jcorbin/pchepa/run_log.md

2024-10-14 08:27 - showing fully charged, unplugged running at full
2024-10-14 10:38 - still going
2024-10-14 13:00 - dead

2024-10-14 13:00 - plugged in, turned knob off
2024-10-14 15:20 - still charging
2024-10-14 17:35 - fully charged
