jcorbin/pchepa/(list of files, cad)

Other CAD files:
duo/wall_noft_2.stl
parts/pwm_knob.stl
pchepa_duo-v1.3.0.3mf
test/power_module.stl
duo/grill_box_b.stl
parts/base_bank_channel_plug.stl
pchepa_tests-v1.3.0.3mf
test/label_plate_a.stl
duo/base_batt_a.stl
parts/wall_bender.stl
test/pwm_ctl_mount.stl
duo/cover_b.stl
parts/wall_bender_brace.stl
test/joiner_clip.stl
duo/cover_a.stl
parts/base_channel_plug.stl
test/label_plate_b.stl
duo/base_bank_a.stl
parts/clip.stl
test/label_b.stl
duo/base_batt_b.stl
test/label_a.stl
duo/batt_house_lid.stl
test/wallslot.stl
duo/grill_box_basic.stl
test/cover_hole.stl
duo/base_bank_b.stl
test/batt_house_tunnel.stl
duo/batt_house_exit.stl
test/grill_ear.stl
duo/base_a.stl
test/power_bank_tunnel.stl
duo/base_label_b.stl
test/wall.stl
duo/base_label_a.stl
duo/batt_house.stl
duo/grill_box_a.stl
duo/base_b.stl
duo/cover_grommet.stl
duo/wall_0.stl
duo/wall_2.stl
duo/wall_3.stl
duo/wall_1.stl
duo/wall_noft_0.stl
duo/wall_noft_3.stl
duo/wall_noft_1.stl
