jcorbin/pchepa/(commit log)

2023-12-22 Ignore stl and slicer project files
2024-03-21 Start out with some reference links
    [pchepa.scad]
2024-03-22 Design through lantern mode
    [pchepa.scad]
2024-03-22 Cleanup organization and update TODOs
    [pchepa.scad]
2024-03-22 Factor out grill screw params
    Use grill screw for cover receptacle
    [pchepa.scad]
2024-03-22 Add fan/filter ghosts to single part modes
    [pchepa.scad]
2024-03-23 Expand to dual variant
    - todo joinery, but basic cover/base plate expansion works
    [pchepa.scad]
2024-03-23 Extend grill to wraparound fans
    [pchepa.scad]
2024-03-23 Add wraparound wall slot
    [pchepa.scad]
2024-03-24 Add buddy mode toggle
    [pchepa.scad]
2024-03-24 Improve plate extra semantics
    [pchepa.scad]
2024-03-24 Add joiner clips
    [pchepa.scad]
2024-03-25 Update metrics for received parts
    [pchepa.scad]
2024-03-25 Add fan wire channels
    [pchepa.scad]
2024-03-25 Add filter grip nubs to cover
    [pchepa.scad]
2024-03-25 Fix grip hollow chamfer edges
    [pchepa.scad]
2024-03-25 Orient cover top-down for exporting
    [pchepa.scad]
2024-03-25 Tune cover from slicer inspection
    [pchepa.scad]
2024-03-25 Tweak tolerancs after first print
    Filter_od = 7 * 25.4;
    [pchepa.scad]
2024-03-26 Double filter tolerance
    [pchepa.scad]
2024-03-26 Trival formatting cleanup
    [pchepa.scad]
2024-03-26 Disable cover wire channel
    [pchepa.scad]
2024-03-26 Increase clip tolerance
    [pchepa.scad]
2024-03-26 Add grill window
    [pchepa.scad]
2024-03-26 Orient grill top-down when exporting
    [pchepa.scad]
2024-03-26 Add port hols thru cover for wiring
    [pchepa.scad]
2024-03-26 Add USB-C port to base, with test mode
    [pchepa.scad]
2024-03-26 Increase usb port tolerance, moar chamfer
    [pchepa.scad]
2024-03-29 Improve back usbc channel chamfer
    [pchepa.scad]
2024-03-30 Update for new usb pd modules
    [pchepa.scad]
2024-03-30 Bump clip tolerance
    [pchepa.scad]
2024-03-31 Iterate on power module fit
    [pchepa.scad]
2024-03-31 Bump clip tolerance again
    [pchepa.scad]
2024-03-31 Flatten power module floor ; modularize
    [pchepa.scad]
2024-03-31 Add plug for base power channel
    [pchepa.scad]
2024-03-31 Rework power module and plug tolerance
    [pchepa.scad]
2024-03-31 Add missing base filter grips
    [pchepa.scad]
2024-03-31 Tweak plate cyl/cube interface
    [pchepa.scad]
2024-04-01 Add wall section
    [pchepa.scad]
2024-04-01 Explicate plate half-disc
    [pchepa.scad]
2024-04-01 Add wall tolerance
    [pchepa.scad]
2024-04-01 Fix wall_section height
    [pchepa.scad]
2024-04-01 Add wall fit test
    [pchepa.scad]
2024-04-01 Add parts, move makefile output
    [pchepa.scad]
2024-04-02 Reclaim dev mode
    [pchepa.scad]
2024-04-02 Hoist slot_id/od
    [pchepa.scad]
2024-04-02 Sanify slot_id/od
    [pchepa.scad]
2024-04-02 Remake wallslot
    - simpler legs based on cube diff
    - direct analogous cyl diff, rather than ring indirection
    - simplify over bosl right/left planar cuts
    [pchepa.scad]
2024-04-02 Bump wall tolerance
    [pchepa.scad]
2024-04-02 Factor out extra computations
    [pchepa.scad]
2024-04-02 Add support for cover heatsets
    [pchepa.scad]
2024-04-02 Increase wall tolerance
    [pchepa.scad]
2024-04-02 Tweak cover heatset hole
    [pchepa.scad]
2024-04-03 Add slight draft to wrapwall
    [pchepa.scad]
2024-04-03 Bump heatset diameter
    [pchepa.scad]
2024-04-03 Add children support to clips
    [pchepa.scad]
2024-04-03 Automate wall section division
    [pchepa.scad]
2024-04-03 Add dovetail joiners to wall section
    [pchepa.scad]
2024-04-03 Fix wall_section Z tolerance
    [pchepa.scad]
2024-04-03 Add wall dovetail test mode
    [pchepa.scad]
2024-04-03 Support varying w/h for wall dovetail test
    [pchepa.scad]
2024-04-03 Subsume dovetail test into wall fit test
    [pchepa.scad]
2024-04-03 Fix wall_section().y
    [pchepa.scad]
2024-04-03 Evolve makefile plumbing
    [pchepa.scad]
2024-04-04 Fix and improve part kit build plate layout
    [pchepa.scad]
2024-04-04 Support clip-only mode for small part kit
    [pchepa.scad]
2024-04-05 Add build v1 time and material notes
2024-04-06 Shift makefile arg shaping ownership
    [pchepa.scad]
2024-04-06 Add example image to readme
    [pchepa.scad]
2024-04-06 Avoid rendering double power sockets
    [pchepa.scad]
2024-04-06 Improve example image
    - manually chosen camera angle
    - dark colors
    - preview ghosts for filter etc
    [pchepa.scad]
2024-04-06 Add some print slicing recommendations
2024-04-07 Dodcument part selection parameters
    [pchepa.scad]
2024-04-07 Globalize buddy and build_plate_size parameters
    [pchepa.scad]
2024-04-07 Cleanup and document HEPA filter parameters
    - hoist to top since this is perhaps *the* primary varying part
    - drop unused filter_spacing parameter
    - drop indirect filter_thickness parameter, just let user set id
    - collect filter_recess and filter_tolerance parameters from cover
    section
    [pchepa.scad]
2024-04-07 Cleanup and document mesh wall parameters
    - make thickness static
    - subsume dovetail spacing into size vector
    [pchepa.scad]
2024-04-08 Cleanup and document PC Fan parameters
    - make fan_id static
    - drop unused fan_spacing
    [pchepa.scad]
2024-04-08 Drop obsolete fan wire channel
    [pchepa.scad]
2024-04-08 Cleanup and document fan grill parameters
    - pushdown grill_size ; factor out grill_padding
    - factor out grill_hole_degree
    [pchepa.scad]
2024-04-08 Pushdown power module integration maths
    [pchepa.scad]
2024-04-08 Move geometry detail section down
    [pchepa.scad]
2024-04-08 Cleanup and document cover parameters
    - improve over/underhang semantics
    [pchepa.scad]
2024-04-08 Fix typo on global buddy param
    [pchepa.scad]
2024-04-08 Rename base_with_{ usbc => power }_port
    [pchepa.scad]
2024-04-08 Cleanup and document clip parameters
    - repack width/length/depth into a size vec3
    [pchepa.scad]
2024-04-08 Cleanup fan_size.z access
    [pchepa.scad]
2024-04-08 Cleanup cover_port xy access
    [pchepa.scad]
2024-04-08 Avoid futile grill window for single filter mode
    [pchepa.scad]
2024-04-08 Cleanup and document power module parameters
    [pchepa.scad]
2024-04-08 Fix slot_od calc for 0 wrapwall_thickness
    [pchepa.scad]
2024-04-08 Fix single-filter wallslot
    [pchepa.scad]
2024-04-10 Factor preview_cut out of power_module_fit_test
    [pchepa.scad]
2024-04-10 Factor prod_orient out of cover and grill modes
    [pchepa.scad]
2024-04-10 Expose clip module parameters
    [pchepa.scad]
2024-04-10 Add rabbit clip tolerance fit test
    [pchepa.scad]
2024-04-10 Make clip test attachable
    prod_orient wasn't a great idea afterall
    [pchepa.scad]
2024-04-10 Rotate clip tolerance test text
    So that the text is right side up when the socket block is set on its
    non-chamfered face.
    [pchepa.scad]
2024-04-10 Add clip socket tolerance to depth
    Also reduc clip_tolerance, since horizontal tolerance doesn't seem to be
    very relevant currently.
    [pchepa.scad]
2024-04-10 Adjust clip tolerance
    - make fit test directly tuned, not factor-coupled to clip_tolerance
    - increase clip_tolerance to 0.5 ; 0.4 works, but just, 0.5 holds well
    and seems a more conservative option
    [pchepa.scad]
2024-04-10 Improve power socket internals
    - nudge power channel back to allow more wallslot width
    - add hallway cut across such, now that the channel is now longer
    touching the power module box itself
    - nudge diaglon cut geometry down, so that it is no longer quit as
    diagonally incident to the wallslot channel
    [pchepa.scad]
2024-04-10 Further improve power socket internals
    - parameterize the channel back offset
    - rework the diagonal cutting plane maths, now slightly less kludgy
    [pchepa.scad]
2024-04-10 Rework make output file structure
    - rename dual => duo
    - separate out test and spare part models
    [pchepa.scad]
2024-04-11 Cleanup and fix test model references
    [pchepa.scad]
2024-04-11 Nudge channel plug tolerance by .05
    [pchepa.scad]
2024-04-11 Fix gemetry detail section ordering
    [pchepa.scad]
2024-04-11 Explicate channel and notch size
    [pchepa.scad]
2024-04-11 Tighten up channel plug fit
    But afford easier tool access to remove
    [pchepa.scad]
2024-04-11 Move example render into duo/
    [pchepa.scad]
2024-04-12 Round wall_sections up to an even number
    Doing so avoids placing a dovetail joint at the far end (point of
    greatest bend) around each plate.
    [pchepa.scad]
2024-04-12 Start tracking made models
    [base.stl, base_with_usbc_port.stl, clip.stl, cover.stl, cover_hole.stl, duo_kit.stl, grill_box.stl, joiner_clip.stl]
2024-04-12 Cut v1.0.1 for publishing
2024-04-12 Link makerworld pre-planned print
2024-05-02 Rework cover and base plates
    - fix discontinuity where plate arc transitions to straight line
    - factor assembly() out of mode 0 and filter_fan()
    - refactor grill_size => grill_size()
    - rework base plate mode(s...)
    - explicate A/B plate modes
    - use mirroring not zrot(180)
    - rework cover plate mode similarly
    - improve base power channel geometry, now separated from base() module
    - trim cut/fill x size
    - trim "backset" gap filler
    - fix Z bump caused by too-tall filler
    - cleanup and improve power module geometry
    - make power_channel_plug_size and power_channel_size 2d
    - rename base_power_channel_plug => channel_plug
    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
    [pchepa.scad]
2024-05-05 Explicate filter lip metric; derive recess
    [pchepa.scad]
2024-05-05 Add small inner chamfer to power socket lip
    Improved test fit module to more readily create test spreads.
    [pchepa.scad]
2024-05-05 Tweak assembly coloring for a nicer readme render
    [pchepa.scad]
2024-05-05 Add support inside clip_socket; reduce tolerance
    - also reduce socket test suite to go lower and finer for further
    testing
    [pchepa.scad]
2024-05-05 Regenerate models
    [base.stl, base_with_usbc_port.stl, cover.stl, cover_hole.stl, duo_kit.stl, grill_box.stl, joiner_clip.stl, power_module.stl]
2024-05-09 Smudge version description into scad
    [pchepa.scad]
2024-05-09 Minor code improvements
    - trivial refactor and reformat thru base/cover/grill and around
    - add preview cutaway toggle parameter
    - factor grill_block out of grill
    - add missing buddy check in grill mode
    - decouple grill inner height / screw length from fan size
    - improve grill/vent/fan assembly using anchors
    - cleanup base power module placement maths
    [pchepa.scad]
2024-05-09 Cut project documentation and qrcode inside base
    [pchepa.scad]
2024-05-09 Splitout A-vs-B models of base/cover/grill
    Also drop base_with_power_port param.
    [pchepa.scad]
2024-05-09 Rename channel plug model
    [pchepa.scad]
2024-05-09 Drop obsolete duo and part models
    [base.stl, base_with_usbc_port.stl, cover.stl, grill_box.stl, power_channel_plug.stl]
2024-05-11 Move pchepa_version below __customizer_limit__
    [pchepa.scad]
2024-05-11 Refactor release script
    - fix idiomatic git-cim alias
    - break main flow up into routines
    - change to always edit for rc
    - further reduce regen parallelism
2024-05-13 Revamp base label text
    - add dedicated dev mode
    - correct filter_id ; check text vs filter interior
    - decrease base text detail
    - stop using github pages for base link
    [pchepa.scad]
2024-05-13 Use vent anchors in grill mode
    [pchepa.scad]
2024-05-13 Add grill screw hole anchors
    [pchepa.scad]
2024-05-13 Factor out and reuse assembly colors
    [pchepa.scad]
2024-05-13 Increase clip compression by 5x
    [pchepa.scad]
2024-05-13 Add filter_extra_space to wall_perim d
    [pchepa.scad]
2024-05-20 Fix wall and cover test filter_count
    [pchepa.scad]
2024-05-20 Decouple wall fit test section length from base
    [pchepa.scad]
2024-05-20 Change cutaway default value
    [pchepa.scad]
2024-05-20 Clarify slot id/od and supporting metrics
    [pchepa.scad]
2024-05-20 Add grill buddy to cover preview
    [pchepa.scad]
2024-05-20 Streamline plate preview modes
    [pchepa.scad]
2024-05-20 Evict base power module buddies
    [pchepa.scad]
2024-05-20 Add undefined fallthru to base_label
    [pchepa.scad]
2024-05-20 Drop base label dev mode
    [pchepa.scad]
2024-05-20 Improve base label depth
    [pchepa.scad]
2024-05-20 Remake wallslot over wallarc using path_sweep
    [pchepa.scad]
2024-05-20 Improve assembly previews
    - color params with higher contrast
    - pre-rendered bodies
    - add curved wall sections
    - add screws
    - add explosion factor
    - add heatset inserts
    - add joiner clips
    - add animated rendering
    [pchepa.scad]
2024-05-20 Replace part kit with A/B assembly modes
    [pchepa.scad]
2024-05-20 Rebuild models
    [base_b.stl, cover_a.stl, cover_b.stl, cover_hole.stl, duo_kit.stl, grill_box_a.stl, grill_box_b.stl, joiner_clip.stl]
2024-05-20 Move power port as close to filter as possible
    [pchepa.scad]
2024-05-20 Add support_walls() cube distributor
    [pchepa.scad]
2024-05-20 Add base plate power bank cavity and tunnel
    [pchepa.scad]
2024-05-20 Add optional fan grill ear with anchor
    [pchepa.scad]
2024-05-20 Add cover notch cutout
    [pchepa.scad]
2024-05-20 Add specific PWM controller inside grill box A
    - replaces prior grill window provision
    - with larger cover port to clear its fan header
    - with a custom knob replacement
    [pchepa.scad]
2024-05-20 Improve mesh wall fit
    - made wall thicker
    - improved dovetail tolerance, but going with un-dovetailed for now
    - but also improved dovetails to be more of a hinge using alternating tapers
    [pchepa.scad]
2024-05-20 Make slot_inner_wall a little thicker
    [pchepa.scad]
2024-05-20 Trim base plate size
    [pchepa.scad]
2024-05-20 Add positive base label models
    [pchepa.scad]
2024-05-20 Add wall bender
    With exploded assembly preview between 2 cover plates
    [pchepa.scad]
2024-05-22 Write v1.1 user guide
    [pchepa.scad]
2024-05-22 Rename base label test plates
    [pchepa.scad]
2024-05-22 Add label plate modes to ui
    [pchepa.scad]
2024-05-22 Always render text and qr shapes
    [pchepa.scad]
2024-05-22 Use named cover/base filter anchor
    [pchepa.scad]
2024-05-22 Cleanup filter_lip_size usage
    [pchepa.scad]
2024-05-22 Revamp base label plates, expand to filter od
    [pchepa.scad]
2024-05-22 Homogenize base and label model anchoring
    [pchepa.scad]
2024-05-28 Fin cover_walls explode
    [pchepa.scad]
2024-05-28 Clarify wrapwall_sections doc string
    [pchepa.scad]
2024-05-28 Cleanup slot/plate diameter integration
    [pchepa.scad]
2024-05-28 Remake wall extrusions
    - remake wall primitive cube as an extruded profile
    - refactor wall_section:
    - isolate diff to dovetail branch
    - indirect wrapwall_dovetail access, allow scalar
    - fix missing female z $eps
    - simplify extra sizing
    - factor out x/rot distributor
    - refactor wallslot:
    - simpler sans turtle, using natural path closure
    - this seems to have fixed the zflip-induced cgal error, allowing for
    normal composition
    - now with slightly better x positioning, via wall_d
    - naturalize profile orientation
    - refactor wall/slot test
    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
    [pchepa.scad]
2024-05-28 Parameterize cover notch position
    Also its edge rounding relative to orientation.
    [pchepa.scad]
2024-05-31 Add git-lfs filter
2024-05-31 Evict STLs into git-lfs
    [base_a.stl, base_b.stl, base_bank_a.stl, base_bank_b.stl, base_bank_channel_plug.stl, base_channel_plug.stl, base_label_b.stl, base_label_plate_a.stl]
2024-05-31 Use scadqr instead of qrcode program
    [pchepa.scad]
2024-05-31 Parameterize label particulars
    [pchepa.scad]
2024-05-31 Add v1.1 release assets
    [pchepa_bom-v1.1.0.xlsx, pchepa_duo_portable-v1.1.2.3mf, pchepa_duo_stationary-v1.1.2.3mf, pchepa_tests-v1.1.2.3mf]
2024-06-08 Enable base label previews again
    ... now that they're more performant
    [pchepa.scad]
2024-06-08 Clarify out test label parts
    [base_label_plate_a.stl, base_label_plate_b.stl, label_a.stl, label_b.stl, label_plate_a.stl, label_plate_b.stl, pchepa.scad]
2024-06-08 Add option to generate bottom-attached label fill
    [pchepa.scad]
2024-06-08 Move base labels to bottom surface
    [pchepa.scad]
2024-06-08 Expand wall modality over dovetail havedness
    [pchepa.scad, wall_section.stl, wall_section_dovetails.stl]
2024-06-08 Update assets for v1.1.3
    - collapse portable and stationary 3mf assets
    [pchepa_duo-v1.1.3.3mf, pchepa_duo_portable-v1.1.2.3mf, pchepa_duo_stationary-v1.1.2.3mf, pchepa_tests-v1.1.2.3mf, pchepa_tests-v1.1.3.3mf]
2024-06-08 Fix and unkludge slot diameters
    - fix wallslot width by moving slot_outer_wall integration to common_od
    - shift and trim wall width from base_od to common_od
    - clarify slot inner/outer wall od integration, 2x radial factors had
    been kludged into prior numbers
    [pchepa.scad]
2024-06-08 Add triangular wall foot
    [pchepa.scad]
2024-06-08 Move cover notch to inner/right side; add to base
    [pchepa.scad]
2024-06-11 Add footless wall models
    [pchepa.scad, wall_noft_0.stl, wall_noft_1.stl, wall_noft_2.stl, wall_noft_3.stl]
2024-06-11 Simplify wall bender mode, add brace sub-mode
    [pchepa.scad, wall_bender.stl, wall_bender_brace.stl]
2024-06-14 Update build guide BOM electronics
    - switch to 15v pd trigger
    - easier to use / more specific set of prefab jst zh 2p wires
2024-06-14 Update BOM spreadsheet for v1.2.0
    [pchepa_bom-v1.1.0.xlsx, pchepa_bom-v1.2.0.xlsx]
2024-06-14 Update 3mf assets for v1.2.0
    [pchepa_duo-v1.1.3.3mf, pchepa_duo-v1.2.0.3mf, pchepa_tests-v1.1.3.3mf, pchepa_tests-v1.2.0.3mf]
2024-10-18 Change fan screw preview color to match actual
    [pchepa.scad]
2024-10-18 Pushdown clip recolor
    [pchepa.scad]
2024-10-18 Drop zombie comment about particular pd trigger
    [pchepa.scad]
2024-10-18 Fix support_walls edge case
    [pchepa.scad]
2024-10-18 Normalize *_extra vars
    - drop unused slot_extra
    - pushdown wall_extra /2 factor
    [pchepa.scad]
2024-10-18 Minor cleanup to base component tags
    [pchepa.scad]
2024-10-20 Add tiny chamfer to base bottom edge
    [pchepa.scad]
2024-10-20 Only show power bank in prime side assembly
    [pchepa.scad]
2024-10-20 Add cover port grommet part
    [pchepa.scad]
2024-10-20 Move pwm ctl mount further towards center
    [pchepa.scad]
2024-10-20 Update changelog for v1.2.1 and current work focus
2024-10-20 Update 3mf projects with v1.2.1 STLs
    [pchepa_duo-v1.2.0.3mf, pchepa_duo-v1.2.1.3mf, pchepa_tests-v1.2.0.3mf, pchepa_tests-v1.2.1.3mf]
2024-10-20 Minimize base height around clip socket rows
    [pchepa.scad]
2024-10-20 Make base pd trigger embed optional
    [pchepa.scad]
2024-10-20 Add new 18650 based battery module
    - embedded in base similar to power bank, but further forward
    - rear exit channel for pwm controller integration
    - this particular design obsoletes the pd trigger port, as the battery
    pack has its own usb-c input
    [pchepa.scad]
2024-10-21 Drop power bank ports image from user guide
    [pchepa.scad]
2024-10-21 Update 3mf projects for v1.3.0
    [pchepa_duo-v1.2.1.3mf, pchepa_duo-v1.3.0.3mf, pchepa_tests-v1.2.1.3mf, pchepa_tests-v1.3.0.3mf]
